Jaycar-Electronics/GPS-World-Clock/drawing/cutout.pdf

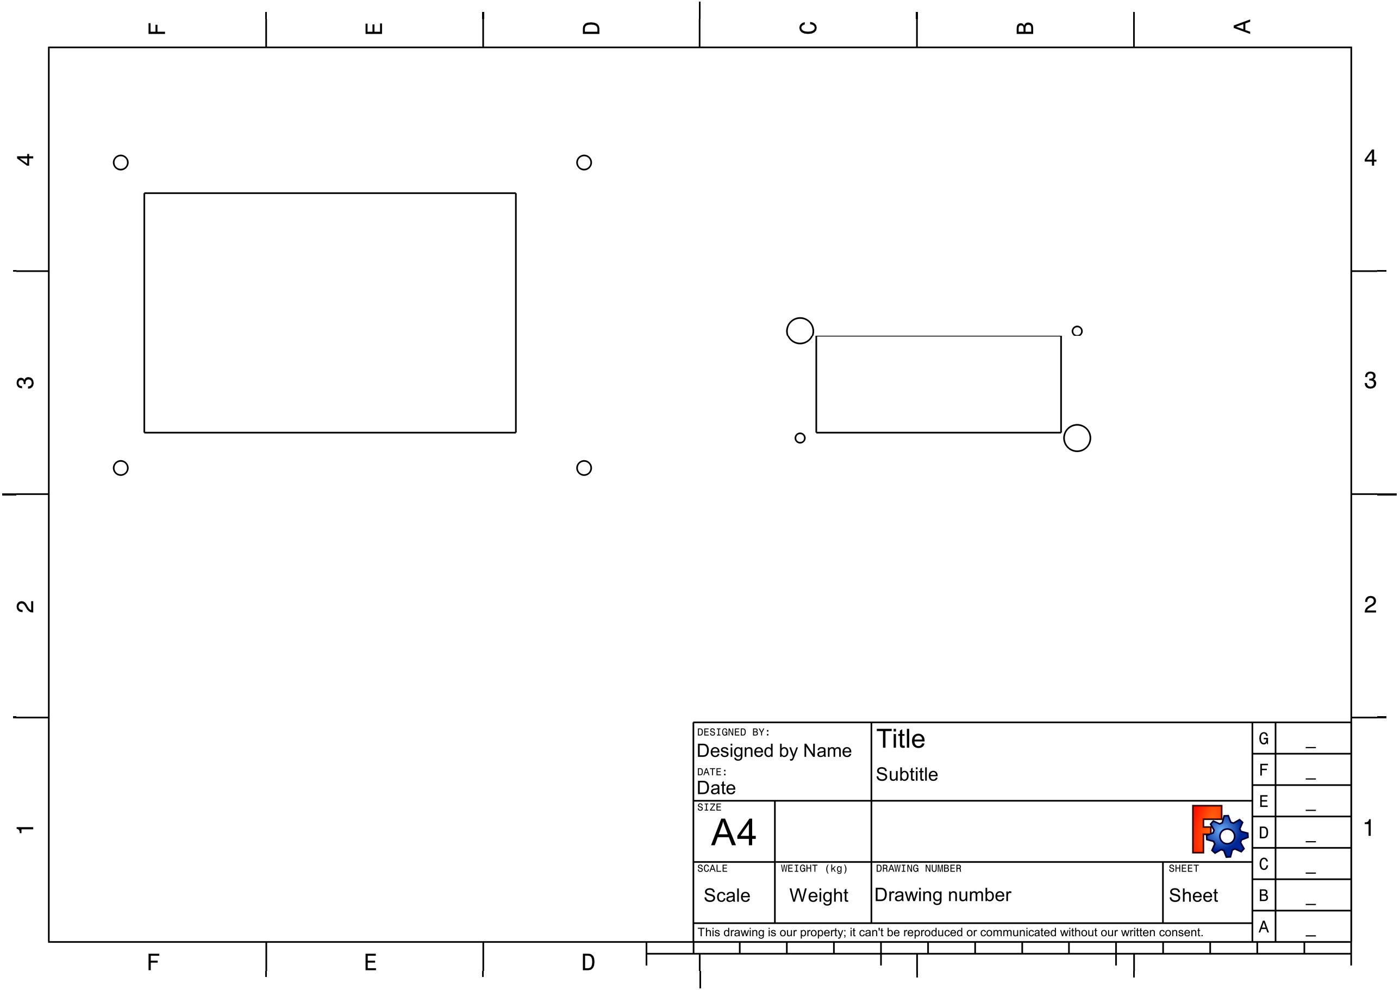
[picture p12: page 1]
