Jaycar-Electronics/GPS-World-Clock/worldclock/bitmap.h

#define bitmap_width 26
#define bitmap_height 26
static const unsigned char bitmap_bits[] = {
   0x00, 0xfc, 0x00, 0x00, 0x80, 0xff, 0x07, 0x00, 0xe0, 0xff, 0x1d, 0x00,
   0xf0, 0xff, 0x21, 0x00, 0xf8, 0xff, 0x41, 0x00, 0xfc, 0xff, 0x84, 0x00,
   0xfc, 0x7f, 0x84, 0x00, 0xfe, 0xff, 0x04, 0x01, 0xfe, 0x7f, 0x06, 0x01,
   0xf6, 0x3f, 0x00, 0x01, 0x61, 0x0e, 0x01, 0x02, 0x21, 0x0c, 0x01, 0x02,
   0x21, 0x1c, 0x01, 0x02, 0x21, 0x00, 0x03, 0x02, 0x01, 0x44, 0x02, 0x02,
   0x01, 0xe4, 0x01, 0x02, 0x02, 0xec, 0x37, 0x01, 0x02, 0x08, 0x00, 0x01,
   0x02, 0x00, 0x08, 0x01, 0x04, 0x00, 0xae, 0x00, 0x04, 0x00, 0xbf, 0x00,
   0x08, 0xc0, 0x5f, 0x00, 0x30, 0xc0, 0x3f, 0x00, 0x60, 0x00, 0x18, 0x00,
   0x80, 0x03, 0x07, 0x00, 0x00, 0xfc, 0x00, 0x00 };
